UMass-Robotics-Club/doggie-power/models/SLW-129956-4A-RA-N-D.step

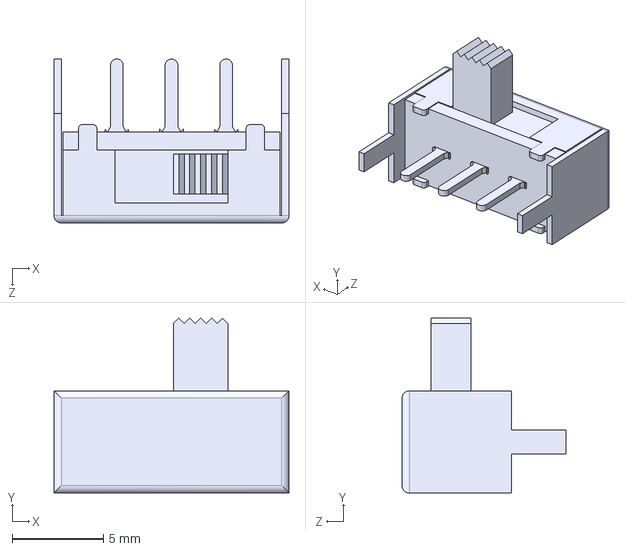
[picture p1: CAD file, 2026-03-17]
models/SLW-129956-4A-RA-N-D.step
12.9 x 9.60 x 9.00 mm
