UMass-Robotics-Club/doggie-power/models/LM5148RGYR.step

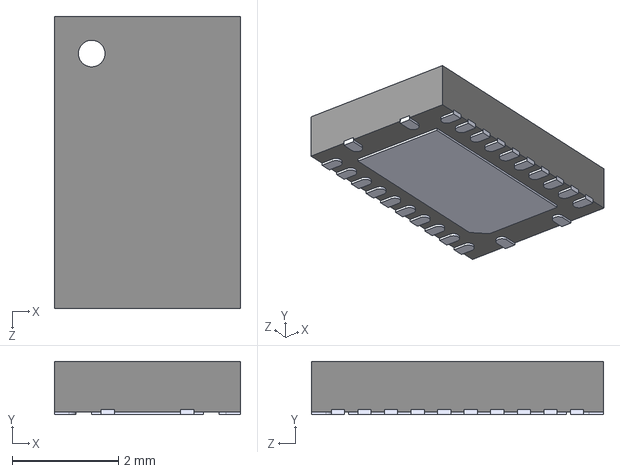
[picture p2: CAD file, 2026-03-06]
models/LM5148RGYR.step
3.50 x 1.00 x 5.50 mm
