UMass-Robotics-Club/doggie-power/models/DRL0006A.stp

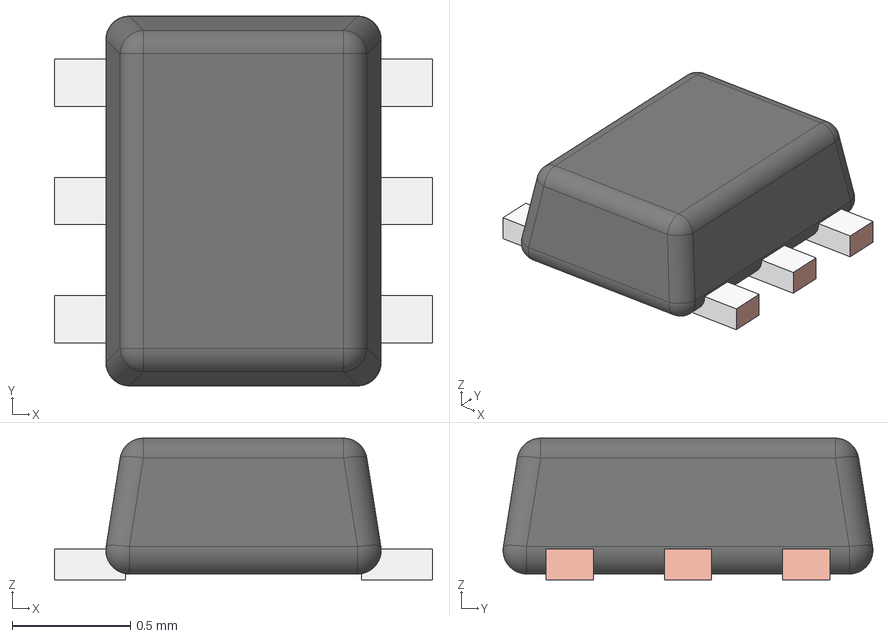
[picture p3: CAD file, 2026-03-06]
models/DRL0006A.stp
1.60 x 1.57 x 0.6 mm
FRAME-DRL0006A
BODY-SOT
PIN1-ID
