UMass-Robotics-Club/doggie-power/models/XT30PW-M.step

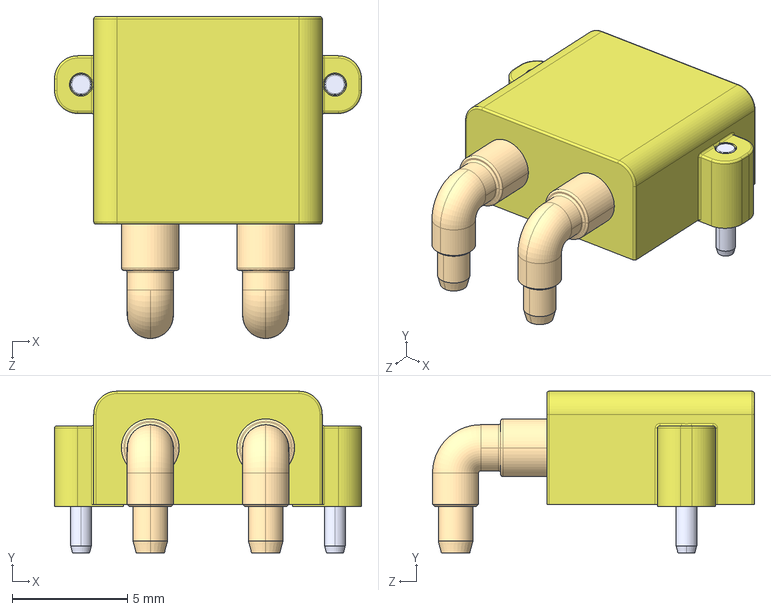
[picture p4: CAD file, 2026-02-12]
models/XT30PW-M.step
13.3 x 7.00 x 14.0 mm
