UMass-Robotics-Club/doggie-power/doggie_board.kicad_pcb

## KiCad design doggie_board.kicad_pcb (2026-04-07)

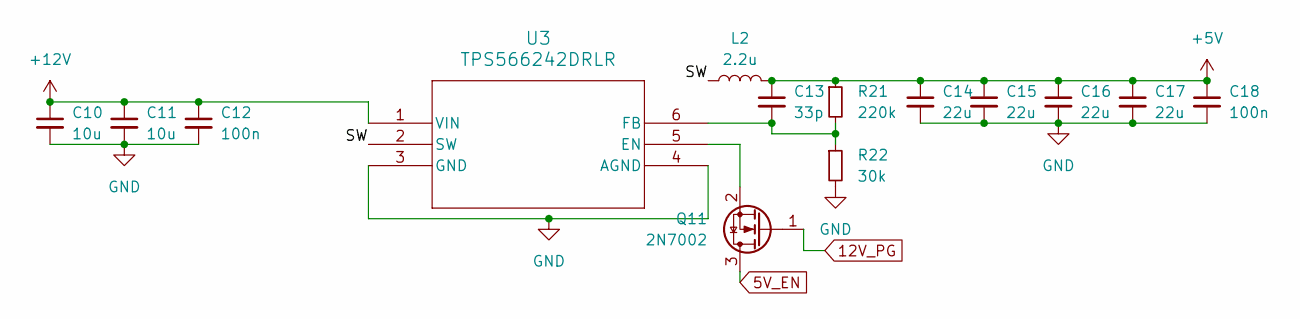
[picture p5: schematic buck5v.kicad_sch, 48v to 5v Buck Converter]

Parts:
C10, C11: 10u; C_0603_1608Metric_Pad1.08x0.95mm_HandSolder
C12, C18: 100n; C_0603_1608Metric_Pad1.08x0.95mm_HandSolder
C13: 33p; C_0603_1608Metric_Pad1.08x0.95mm_HandSolder
C14, C15, C16, C17: 22u; C_0603_1608Metric_Pad1.08x0.95mm_HandSolder
L2: 2.2u; IND_1217AS-H-2R2N=P3
Q11: 2N7002; SOT-23
R21: 220k; R_0603_1608Metric_Pad0.98x0.95mm_HandSolder
R22: 30k; R_0603_1608Metric_Pad0.98x0.95mm_HandSolder
U3: TPS566242DRLR; SOT5x3_DRL_TEX

Connections:
5V_EN: Q11.3 (D); also elsewhere on the board
12V_PG: Q11.1 (G); also elsewhere on the board
+5V: C13.1, C14.1, C15.1, C16.1, C17.1, C18.1, L2.2, R21.1; also elsewhere on the board
+12V: C10.1, C11.1, C12.1, U3.1 (VIN); also elsewhere on the board
/5v Buck Converter/SW: L2.1, U3.2 (SW)
GND: C10.2, C11.2, C12.2, C14.2, C15.2, C16.2, C17.2, C18.2, R22.2, U3.3 (GND), U3.4 (AGND); also elsewhere on the board
unnamed: Q11.2 (S), U3.5 (EN)
unnamed: C13.2, R21.2, R22.1, U3.6 (FB)

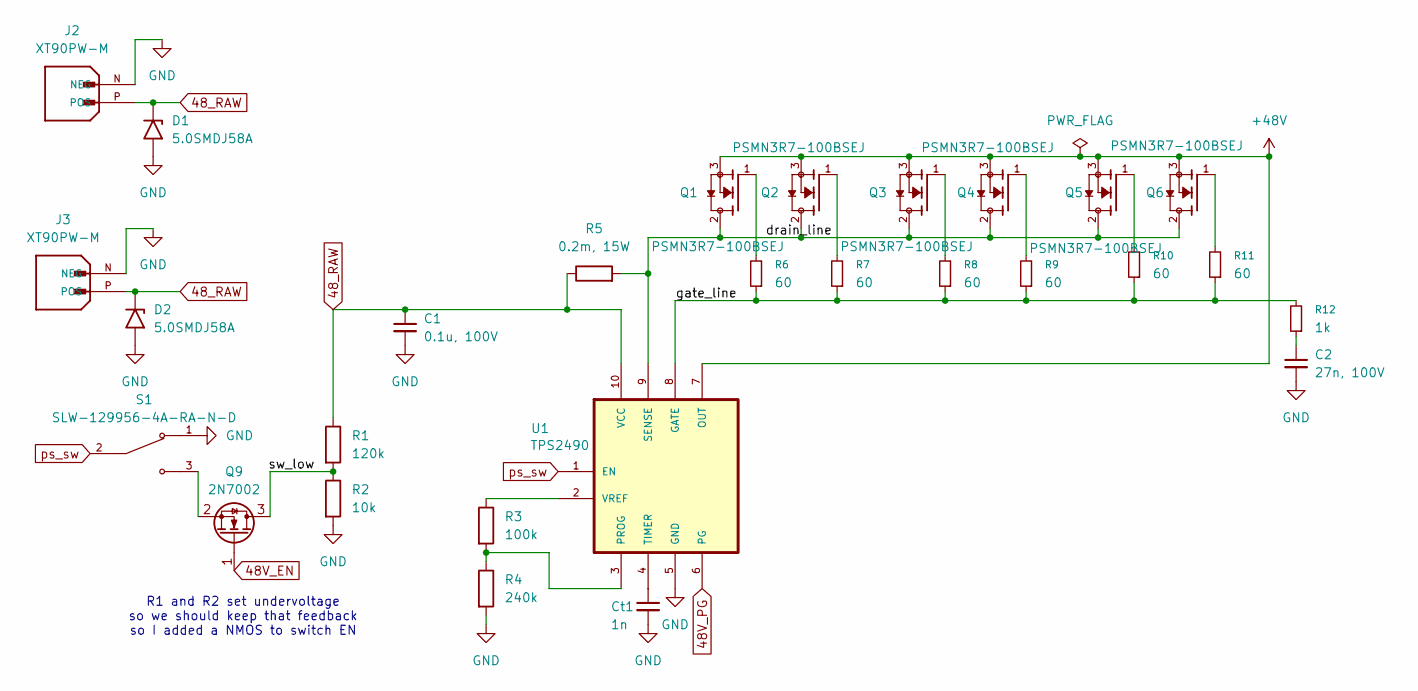
[picture p6: schematic power_switch.kicad_sch, High Side Power Switch]

Parts:
C1: 0.1u, 100V; C_0603_1608Metric_Pad1.08x0.95mm_HandSolder
C2: 27n, 100V; C_0603_1608Metric_Pad1.08x0.95mm_HandSolder
Ct1: 1n; C_0603_1608Metric_Pad1.08x0.95mm_HandSolder
D1, D2: 5.0SMDJ58A; D_SMB-SMC_Universal_Handsoldering
J2, J3: XT90PW-M; AMASS_XT90PW-M; PARTREV V00
Q1, Q2, Q3, Q4, Q5, Q6: PSMN3R7-100BSEJ; D2PAK_NEX; PARTREV 3 September 2018
Q9: 2N7002; SOT-23
R1: 120k; R_0603_1608Metric_Pad0.98x0.95mm_HandSolder
R2: 10k; R_0603_1608Metric_Pad0.98x0.95mm_HandSolder
R3: 100k; R_0603_1608Metric_Pad0.98x0.95mm_HandSolder
R4: 240k; R_0603_1608Metric_Pad0.98x0.95mm_HandSolder
R5: 0.2m, 15W; RES_PSR500_ROM
R6, R7, R8, R9, R10, R11: 60; R_0603_1608Metric_Pad0.98x0.95mm_HandSolder
R12: 1k; R_0603_1608Metric_Pad0.98x0.95mm_HandSolder
S1: SLW-129956-4A-RA-N-D; SW_SLW-129956-4A-RA-N-D; PARTREV 1.01
U1: TPS2490; VSSOP-10_3x3mm_P0.5mm

Connections:
48V_EN: Q9.1 (G); also elsewhere on the board
48V_PG: U1.6 (PG); also elsewhere on the board
48_RAW: C1.1, D1.1 (A1), D2.1 (A1), J2.P (POS), J3.P (POS), R1.1, R5.1, U1.10 (VCC); also elsewhere on the board
+48V: Q1.3, Q2.3, Q3.3, Q4.3, Q5.3, Q6.3, U1.7 (OUT); also elsewhere on the board
/High Side Power Switch/drain_line: Q1.2, Q2.2, Q3.2, Q4.2, Q5.2, Q6.2, R5.2, U1.9 (SENSE)
/High Side Power Switch/gate_line: R6.1, R7.1, R8.1, R9.1, R10.1, R11.1, R12.2, U1.8 (GATE)
/High Side Power Switch/sw_low: Q9.3 (D), R1.2, R2.1
GND: C1.2, C2.2, Ct1.2, D1.2 (A2), D2.2 (A2), J2.N (NEG), J3.N (NEG), R2.2, R4.2, S1.1, U1.5 (GND); also elsewhere on the board
unnamed: C2.1, R12.1
unnamed: Q1.1, R6.2
unnamed: Q2.1, R7.2
unnamed: Q3.1, R8.2
unnamed: Q4.1, R9.2
unnamed: Q5.1, R10.2
unnamed: Q6.1, R11.2
unnamed: Q9.2 (S), S1.3
unnamed: R3.2, R4.1, U1.3 (PROG)
unnamed: Ct1.1, U1.4 (TIMER)
unnamed: R3.1, U1.2 (VREF)
ps_sw: S1.2, U1.1 (EN)

Notes on the sheet:
R1 and R2 set undervoltage so we should keep that feedback so I added a NMOS to switch EN

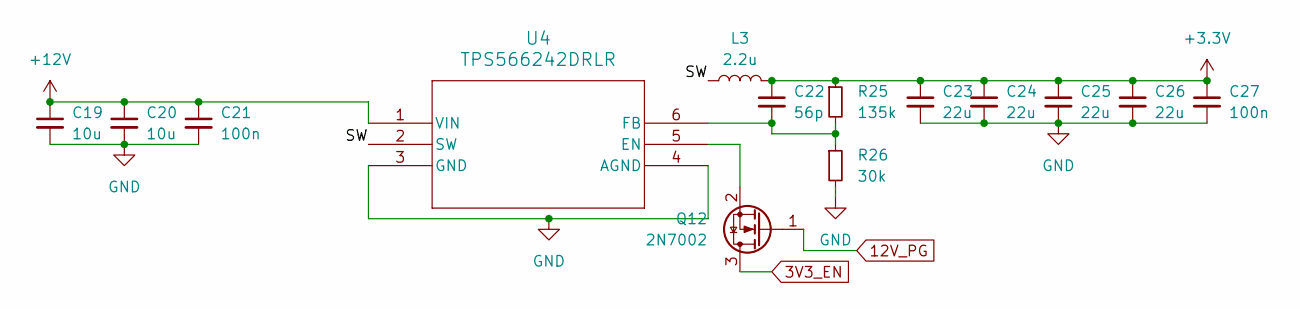
[picture p7: schematic untitled.kicad_sch, 48v to 3.3v Converter]

Parts:
C19, C20: 10u; C_0603_1608Metric_Pad1.08x0.95mm_HandSolder
C21, C27: 100n; C_0603_1608Metric_Pad1.08x0.95mm_HandSolder
C22: 56p; C_0603_1608Metric_Pad1.08x0.95mm_HandSolder
C23, C24, C25, C26: 22u; C_0603_1608Metric_Pad1.08x0.95mm_HandSolder
L3: 2.2u; IND_1217AS-H-2R2N=P3
Q12: 2N7002; SOT-23
R25: 135k; R_0603_1608Metric_Pad0.98x0.95mm_HandSolder
R26: 30k; R_0603_1608Metric_Pad0.98x0.95mm_HandSolder
U4: TPS566242DRLR; SOT5x3_DRL_TEX

Connections:
3V3_EN: Q12.3 (D); also elsewhere on the board
12V_PG: Q12.1 (G); also elsewhere on the board
+3.3V: C22.1, C23.1, C24.1, C25.1, C26.1, C27.1, L3.2, R25.1; also elsewhere on the board
+12V: C19.1, C20.1, C21.1, U4.1 (VIN); also elsewhere on the board
/3.3v Buck Converter/SW: L3.1, U4.2 (SW)
GND: C19.2, C20.2, C21.2, C23.2, C24.2, C25.2, C26.2, C27.2, R26.2, U4.3 (GND), U4.4 (AGND); also elsewhere on the board
unnamed: Q12.2 (S), U4.5 (EN)
unnamed: C22.2, R25.2, R26.1, U4.6 (FB)

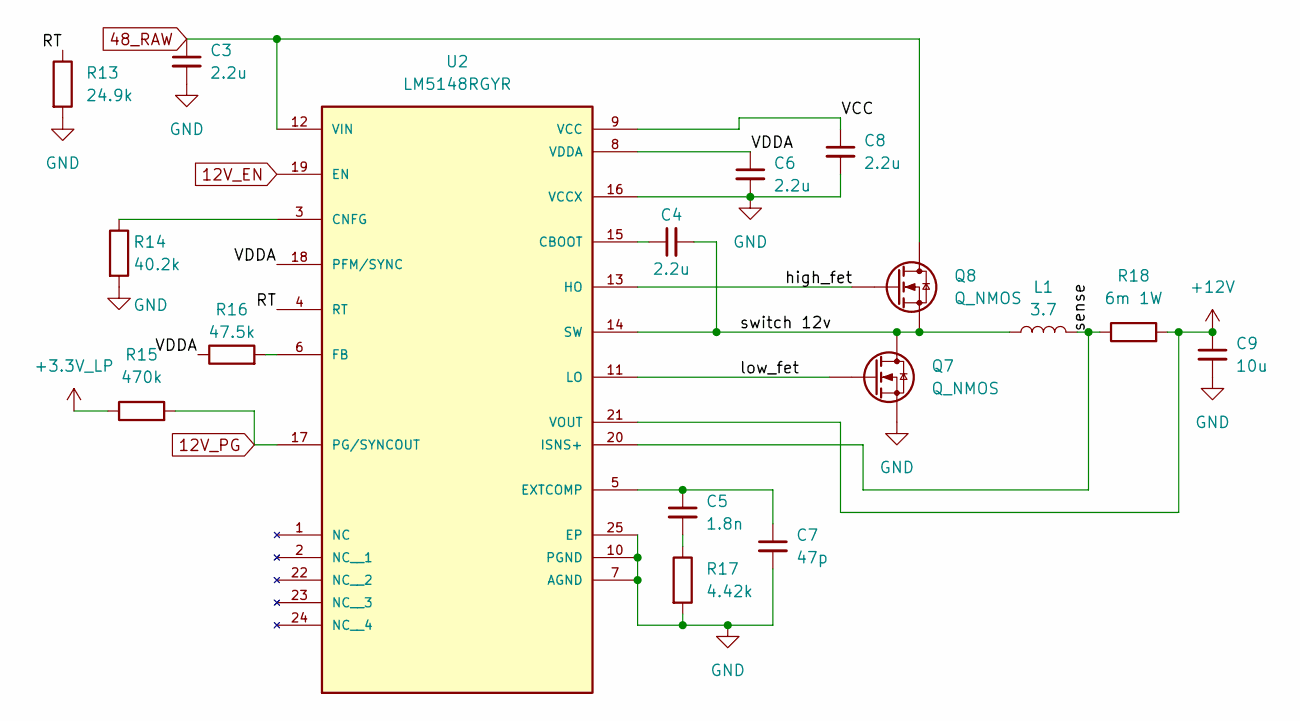
[picture p8: schematic buck12v.kicad_sch, 48 to 12v Buck Converter]

Parts:
C3, C4, C6, C8: 2.2u; C_0603_1608Metric_Pad1.08x0.95mm_HandSolder
C5: 1.8n; C_0603_1608Metric_Pad1.08x0.95mm_HandSolder
C7: 47p; C_0603_1608Metric_Pad1.08x0.95mm_HandSolder
C9: 10u; C_0603_1608Metric_Pad1.08x0.95mm_HandSolder
L1: 3.7; P1173.372NL
Q7, Q8: Q_NMOS; TO-252-2
R13: 24.9k; R_0603_1608Metric_Pad0.98x0.95mm_HandSolder
R14: 40.2k; R_0603_1608Metric_Pad0.98x0.95mm_HandSolder
R15: 470k; R_0603_1608Metric_Pad0.98x0.95mm_HandSolder
R16: 47.5k; R_0603_1608Metric_Pad0.98x0.95mm_HandSolder
R17: 4.42k; R_0603_1608Metric_Pad0.98x0.95mm_HandSolder
R18: 6m 1W; R_1206_3216Metric_Pad1.30x1.75mm_HandSolder
U2: LM5148RGYR; PARTEV February 2023

Connections:
12V_EN: U2.19 (EN); also elsewhere on the board
12V_PG: R15.2, U2.17 (PG/SYNCOUT); also elsewhere on the board
48_RAW: C3.1, Q8.2 (D), U2.12 (VIN); also elsewhere on the board
+3.3V_LP: R15.1; also elsewhere on the board
+12V: C9.1, R18.2, U2.21 (VOUT); also elsewhere on the board
/12v Buck Converter/RT: R13.1, U2.4 (RT)
/12v Buck Converter/VCC: C8.1, U2.9 (VCC)
/12v Buck Converter/VDDA: C6.1, R16.1, U2.8 (VDDA), U2.18 (PFM/SYNC)
/12v Buck Converter/high_fet: Q8.1 (G), U2.13 (HO)
/12v Buck Converter/low_fet: Q7.1 (G), U2.11 (LO)
/12v Buck Converter/sense: L1.2, R18.1, U2.20 (ISNS+)
/12v Buck Converter/switch 12v: C4.2, L1.1, Q7.2 (D), Q8.3 (S), U2.14 (SW)
GND: C3.2, C6.2, C7.2, C8.2, C9.2, Q7.3 (S), R13.2, R14.2, R17.2, U2.7 (AGND), U2.10 (PGND), U2.16 (VCCX), U2.25 (EP); also elsewhere on the board
unnamed: C5.2, R17.1
unnamed: C4.1, U2.15 (CBOOT)
unnamed: R14.1, U2.3 (CNFG)
unnamed: C5.1, C7.1, U2.5 (EXTCOMP)
unnamed: R16.2, U2.6 (FB)

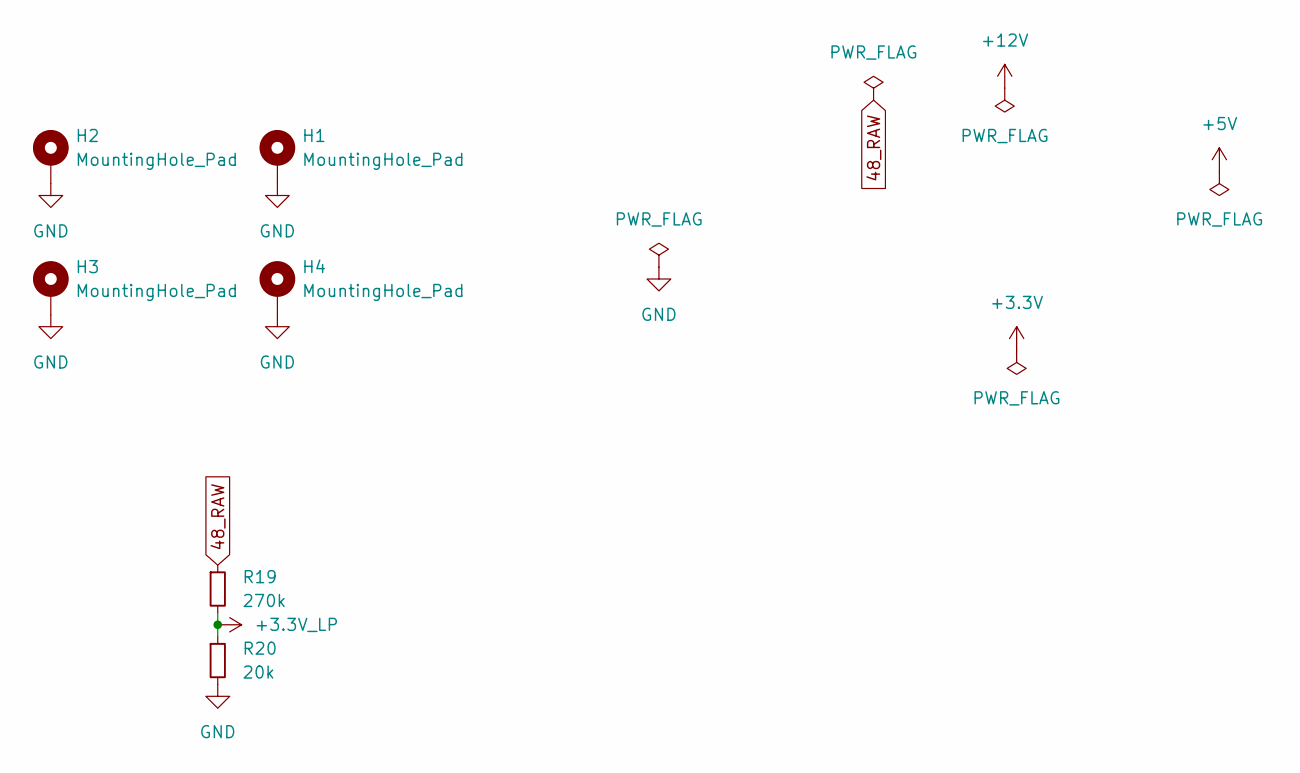
[picture p9: schematic misc.kicad_sch]

Parts:
H1, H2, H3, H4: MountingHole_Pad; MountingHole_3.2mm_M3_DIN965_Pad_TopBottom
R19: 270k; R_0603_1608Metric_Pad0.98x0.95mm_HandSolder
R20: 20k; R_0603_1608Metric_Pad0.98x0.95mm_HandSolder

Connections:
48_RAW: R19.1; also elsewhere on the board
+3.3V_LP: R19.2, R20.1; also elsewhere on the board
GND: H1.1, H2.1, H3.1, H4.1, R20.2; also elsewhere on the board

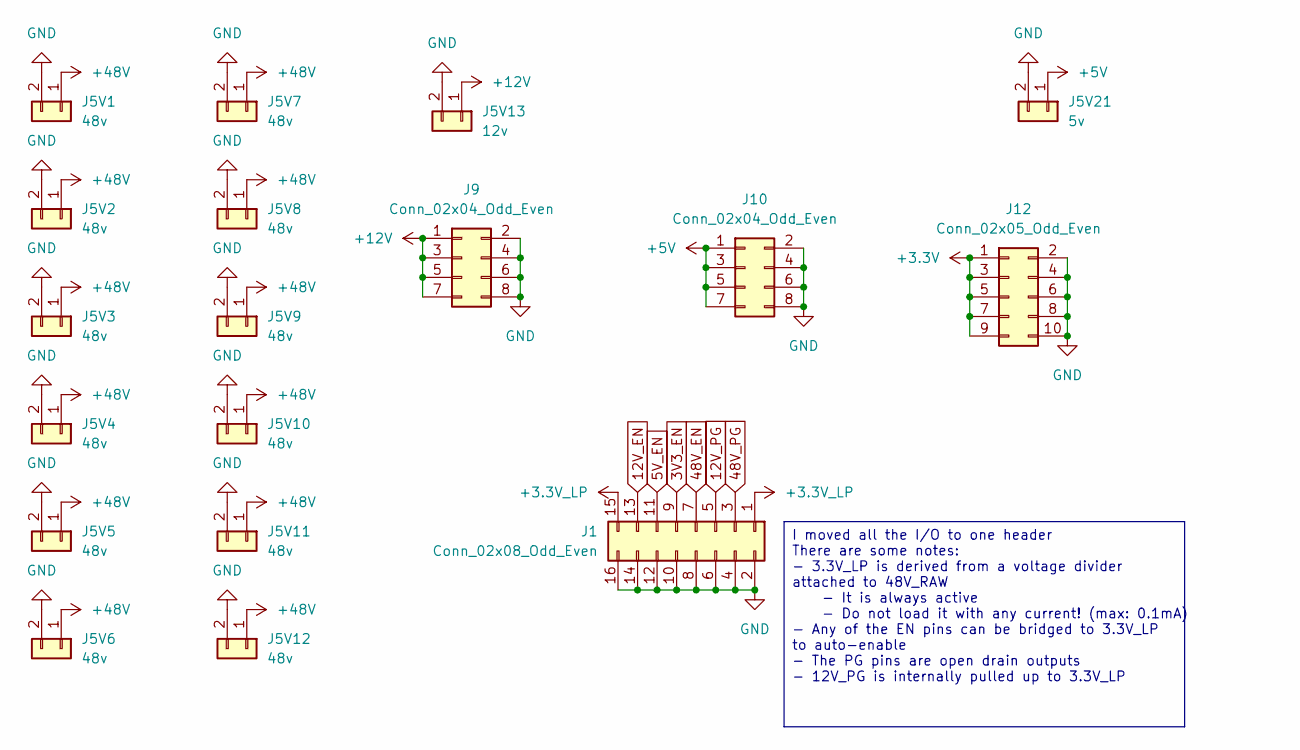
[picture p10: schematic connectors.kicad_sch]

Parts:
J1: Conn_02x08_Odd_Even; PinHeader_2x08_P2.54mm_Vertical
J5V1, J5V2, J5V3, J5V4, J5V5, J5V6, J5V7, J5V8, J5V9, J5V10, J5V11, J5V12: 48v; AMASS_XT30PW-M_1x02_P2.50mm_Horizontal
J5V13: 12v; CUI_PJ-037A
J5V21: 5v; CUI_PJ-037A
J9, J10: Conn_02x04_Odd_Even; PinHeader_2x04_P2.54mm_Vertical
J12: Conn_02x05_Odd_Even; PinHeader_2x05_P2.54mm_Vertical

Connections:
3V3_EN: J1.9; also elsewhere on the board
5V_EN: J1.11; also elsewhere on the board
12V_EN: J1.13; also elsewhere on the board
12V_PG: J1.5; also elsewhere on the board
48V_EN: J1.7; also elsewhere on the board
48V_PG: J1.3; also elsewhere on the board
+3.3V: J12.1, J12.3, J12.5, J12.7, J12.9; also elsewhere on the board
+3.3V_LP: J1.1, J1.15; also elsewhere on the board
+5V: J5V21.1, J10.1, J10.3, J10.5, J10.7; also elsewhere on the board
+12V: J5V13.1, J9.1, J9.3, J9.5, J9.7; also elsewhere on the board
+48V: J5V1.1, J5V2.1, J5V3.1, J5V4.1, J5V5.1, J5V6.1, J5V7.1, J5V8.1, J5V9.1, J5V10.1, J5V11.1, J5V12.1; also elsewhere on the board
GND: J1.2, J1.4, J1.6, J1.8, J1.10, J1.12, J1.14, J1.16, J5V1.2, J5V2.2, J5V3.2, J5V4.2, J5V5.2, J5V6.2, J5V7.2, J5V8.2, J5V9.2, J5V10.2, J5V11.2, J5V12.2, J5V13.2, J5V21.2, J9.2, J9.4, J9.6, J9.8, J10.2, J10.4, J10.6, J10.8, J12.2, J12.4, J12.6, J12.8, J12.10; also elsewhere on the board

Notes on the sheet:
I moved all the I/O to one header There are some notes: - 3.3V_LP is derived from a voltage divider attached to 48V_RAW - It is always active - Do not load it with any current! (max: 0.1mA) - Any of the EN pins can be bridged to 3.3V_LP to auto-enable - The PG pins are open drain outputs - 12V_PG i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

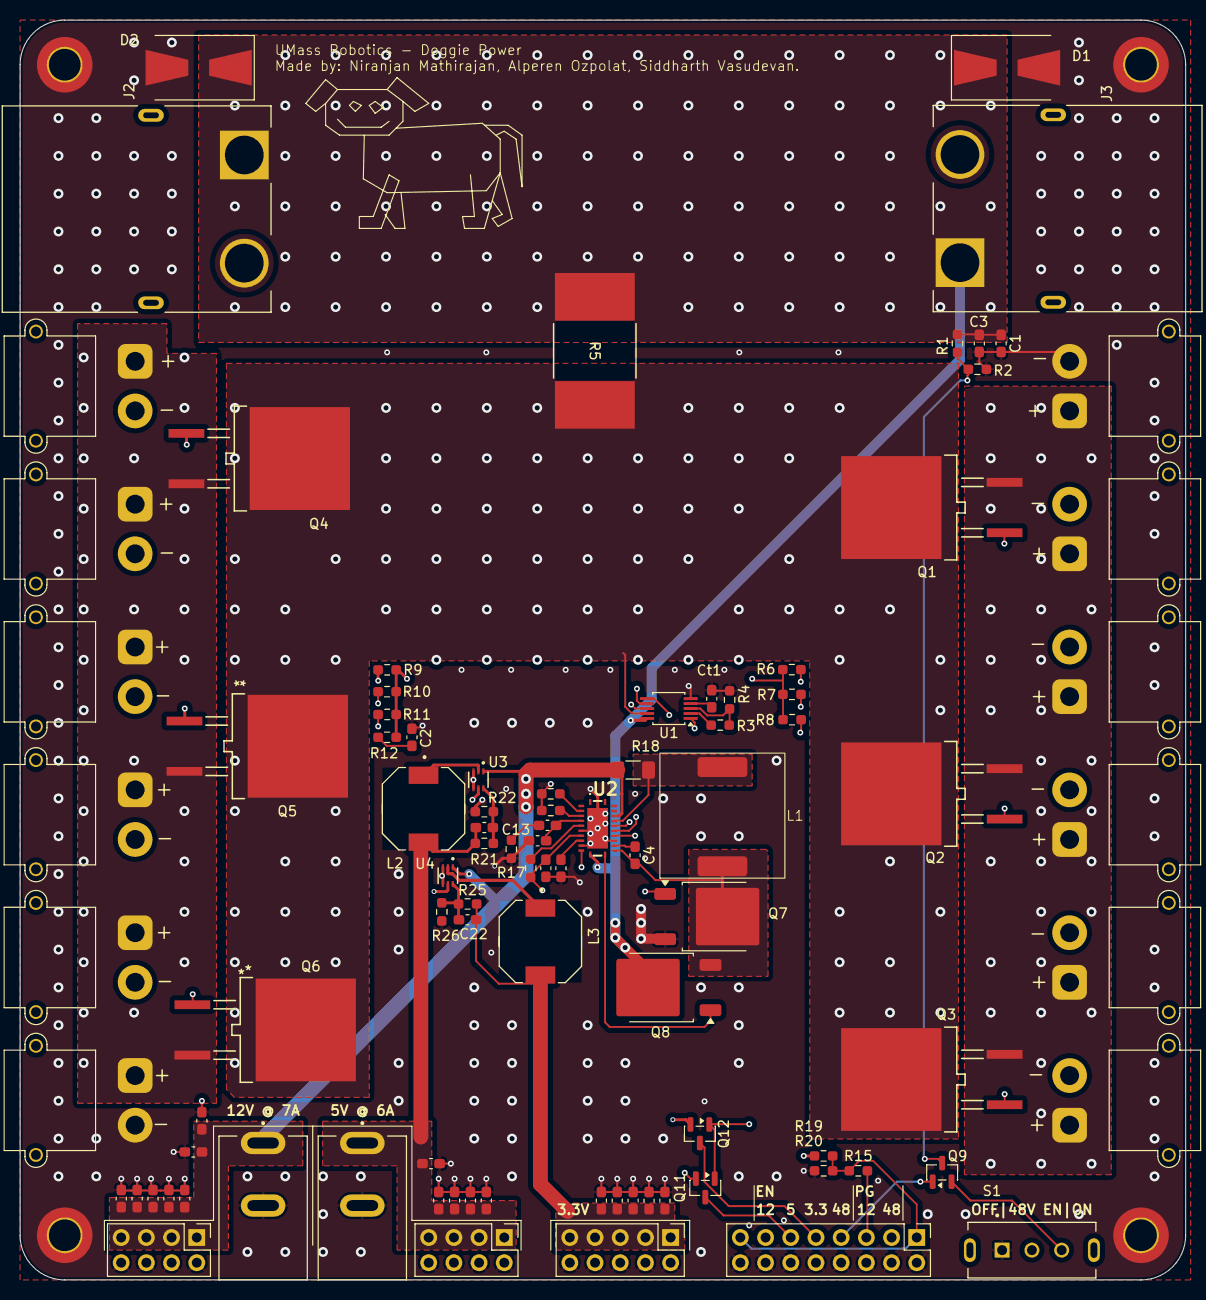
[picture p11: board doggie_board.kicad_pcb from above]

Board: 4 copper layers, 117.5 x 127.0 mm, 97 parts (0 on the bottom side), 46 nets.
