UMass-Robotics-Club/doggie-power/(commit log)

2025-10-20 initial hot swap controller
    [LM5069_Design_Calculator_REV_C.ods, LM5069_Design_Calculator_REV_C.xlsx, doggie_board.kicad_pcb, doggie_board.kicad_sch, power_switch.kicad_sch]
2025-10-28 Addition of Buck Converter
    [doggie_board.kicad_sch, untitled.kicad_sch]
2025-11-18 Buck_Converter
    Ensure it was properly pushed
    [doggie_board.kicad_sch]
2025-11-24 feat: added power switch schematics
    [LM5069_Design_Calculator_REV_C.ods, LM5069_Design_Calculator_REV_C.xlsx, power_switch.kicad_sch]
2025-11-24 added calculator
    [TPS249x_8x_Design_Calculator_REV_B.ods]
2026-02-04 fix nets
    [power_switch.kicad_sch]
2026-02-04 cleaned up file structure
    [buckconv2.kicad_sch, power_switch.kicad_sch, untitled.kicad_sch]
2026-02-04 feat: 48-5v buck converter
    [buckconv2.kicad_sch, power_switch.kicad_sch, untitled.kicad_sch]
2026-02-05 Fixed ERC
    Created Buck3
    [buckconv2.kicad_sch, doggie_board.kicad_sch, untitled.kicad_sch]
2026-02-05 fixed ERC errors and footprint for the TPS2490
    [doggie_board.kicad_sch, power_switch.kicad_sch]
2026-02-05 Cleaned up repo, fixing naming
    [buck12v.kicad_sch, buck5v.kicad_sch, buckconv2.kicad_sch, doggie_board.kicad_sch, untitled.kicad_sch]
2026-02-05 fixed footprints
    [buck12v.kicad_sch, buck5v.kicad_sch, buckconv2.kicad_sch, doggie_board.kicad_sch, power_switch.kicad_sch]
2026-02-05 fixed ERC
    [power_switch.kicad_sch]
2026-02-09 moved schematics back to root folder
    [buck12v.kicad_sch, buck5v.kicad_sch, connectors.kicad_sch, doggie_board.kicad_sch, power_switch.kicad_sch]
2026-02-10 3.3v linear converter
    added linear converter
    [doggie_board.kicad_sch, untitled.kicad_sch]
2026-02-10 started routing
    [doggie_board.kicad_pcb, power_switch.kicad_sch]
2026-02-12 Connectors Created
    Footprints added
    [connectors.kicad_sch, untitled.kicad_sch]
2026-02-12 Connectors (fixed)
    [XT30PW-M.step]
2026-02-12 progress on routing
    [buck5v.kicad_sch, doggie_board.kicad_pcb, power_switch.kicad_sch]
2026-02-19 Renaming of Parts
    Rename
    [buck12v.kicad_sch, buck5v.kicad_sch, connectors.kicad_sch, power_switch.kicad_sch, untitled.kicad_sch]
2026-02-19 updated footprints and pcb
    [connectors.kicad_sch, doggie_board.kicad_pcb, power_switch.kicad_sch]
2026-03-02 imported schematic
    [doggie_board.kicad_pcb]
2026-03-03 routing progress
    [buck12v.kicad_sch, buck5v.kicad_sch, connectors.kicad_sch, doggie_board.kicad_pcb, power_switch.kicad_sch, untitled.kicad_sch]
2026-03-04 transistor pins
    [doggie_board.kicad_pcb, power_switch.kicad_sch]
2026-03-04 progress on right drain
    [doggie_board.kicad_pcb]
2026-03-05 swapped left and right
    [doggie_board.kicad_pcb, power_switch.kicad_sch]
2026-03-06 Fixed Schematics with more cost effective IC's
    [DRL0006A.stp, LM5148RGYR.step, TPS249x_8x_Design_Calculator_REV_B.ods, buck12v.kicad_sch, buck5v.kicad_sch, connectors.kicad_sch, doggie_board.kicad_pcb, doggie_board.kicad_sch]
2026-03-07 feat: added footprints
    [buck12v.kicad_sch, buck5v.kicad_sch, connectors.kicad_sch, doggie_board.kicad_pcb, misc.kicad_sch, power_switch.kicad_sch, untitled.kicad_sch]
2026-03-08 added headers and modified some stuff
    [buck12v.kicad_sch, buck5v.kicad_sch, power_switch.kicad_sch, untitled.kicad_sch]
2026-03-08 added footprints and standardized EN headers
    [buck12v.kicad_sch, buck5v.kicad_sch, doggie_board.kicad_pcb, power_switch.kicad_sch, untitled.kicad_sch]
2026-03-09 pcb routing
    [TPS249x_8x_Design_Calculator_REV_B.ods, buck12v.kicad_sch, connectors.kicad_sch, doggie_board.kicad_pcb, misc.kicad_sch, power_switch.kicad_sch]
2026-03-11 additional progress on routing front copper
    [doggie_board.kicad_pcb]
2026-03-15 march 14
    [doggie_board.kicad_pcb]
2026-03-15 final push
    [buck12v.kicad_sch, buck5v.kicad_sch, doggie_board.kicad_pcb, untitled.kicad_sch]
2026-03-15 fix pads
    [TPS249x_8x_Design_Calculator_REV_B.ods, doggie_board.kicad_pcb, power_switch.kicad_sch]
2026-03-15 added spencer suggestion
    [doggie_board.kicad_pcb]
2026-03-16 added my name
    [doggie_board.kicad_pcb]
2026-03-16 om suggestions
    [buck12v.kicad_sch, connectors.kicad_sch, doggie_board.kicad_pcb]
2026-03-16 shortened board
    [connectors.kicad_sch, doggie_board.kicad_pcb]
2026-03-17 fixed clearances
    [doggie_board.kicad_pcb]
2026-03-17 added switch and cleaned up board a little
    [SLW-129956-4A-RA-N-D.step, doggie_board.kicad_pcb, power_switch.kicad_sch]
2026-03-17 fixed footprintns
    [buck12v.kicad_sch, buck5v.kicad_sch, doggie_board.kicad_pcb, power_switch.kicad_sch, untitled.kicad_sch]
2026-03-17 fixed vias and added stitching
    [doggie_board.kicad_pcb]
2026-03-17 added header labels
    [doggie_board.kicad_pcb]
2026-03-18 aligned mounting holes and csr
    [doggie_board.kicad_pcb]
2026-03-18 reordered names
    [doggie_board.kicad_pcb]
2026-03-18 fixed mounting holes and added rounded corners
    [doggie_board.kicad_pcb]
2026-03-18 fixed 3d models for xt30
    [doggie_board.kicad_pcb]
2026-03-18 updated headers
    [buck12v.kicad_sch, buck5v.kicad_sch, connectors.kicad_sch, doggie_board.kicad_pcb, misc.kicad_sch, power_switch.kicad_sch, untitled.kicad_sch]
2026-04-07 upadated board to use 2 power layers
    [buck12v.kicad_sch, doggie_board.kicad_pcb]
2026-04-07 removed extra silkscreen
    [doggie_board.kicad_pcb]
